chanslor/ESP32_HYDRO_STATIC/price-list.txt

HiLetgo  INA219 I2C Bi-Directional DC Current Power Supply Sensor Breakout Module - $8.19

915 MHz ESP32 LoRa 32 V3 OLED Display Board + LoRa32 V3 Case Cover + LoRa Antenna 915MHz for Heltec Meshtastic LoraWan IOT  - $25

HiLetgo  LM393 3.3V-5V Soil Moisture Detect Sensor Soil Moisture Sensor Soil Hygrometer - $2

Snapware Total Solution Food Storage Container, Plastic, Rectangle, 8.5 Cups - $7 

SEFEPODER 12 Volt 7ah Rechargeable Sealed Lead Acid Battery - $15

Liquid Level Sensor, TL-136 12-32VDC 4-20mA Signal Output Anti-blocking Water Level Sensor Detector, Liquid Level Transmitter(0-1m) - $44.54
