chanslor/ESP32_HYDRO_STATIC/Heltec-amazon.png

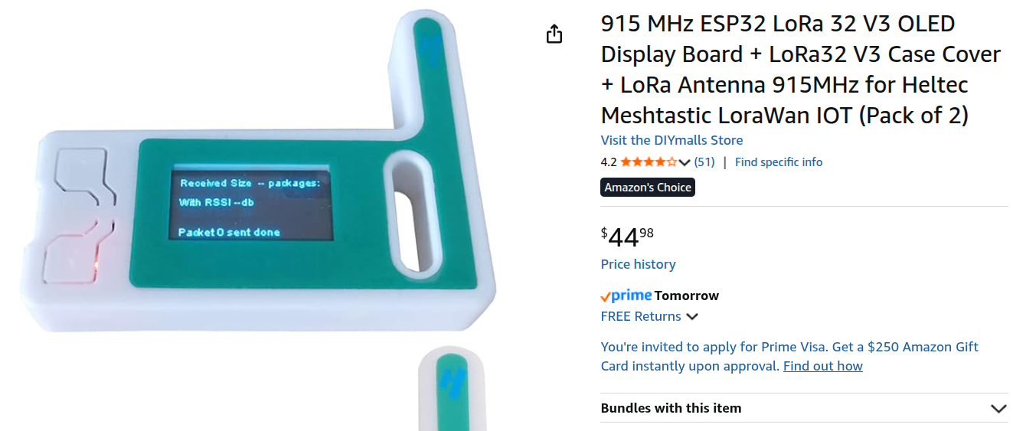
Heltec-amazon.png
