chanslor/ESP32_HYDRO_STATIC/orginal-design.jpg

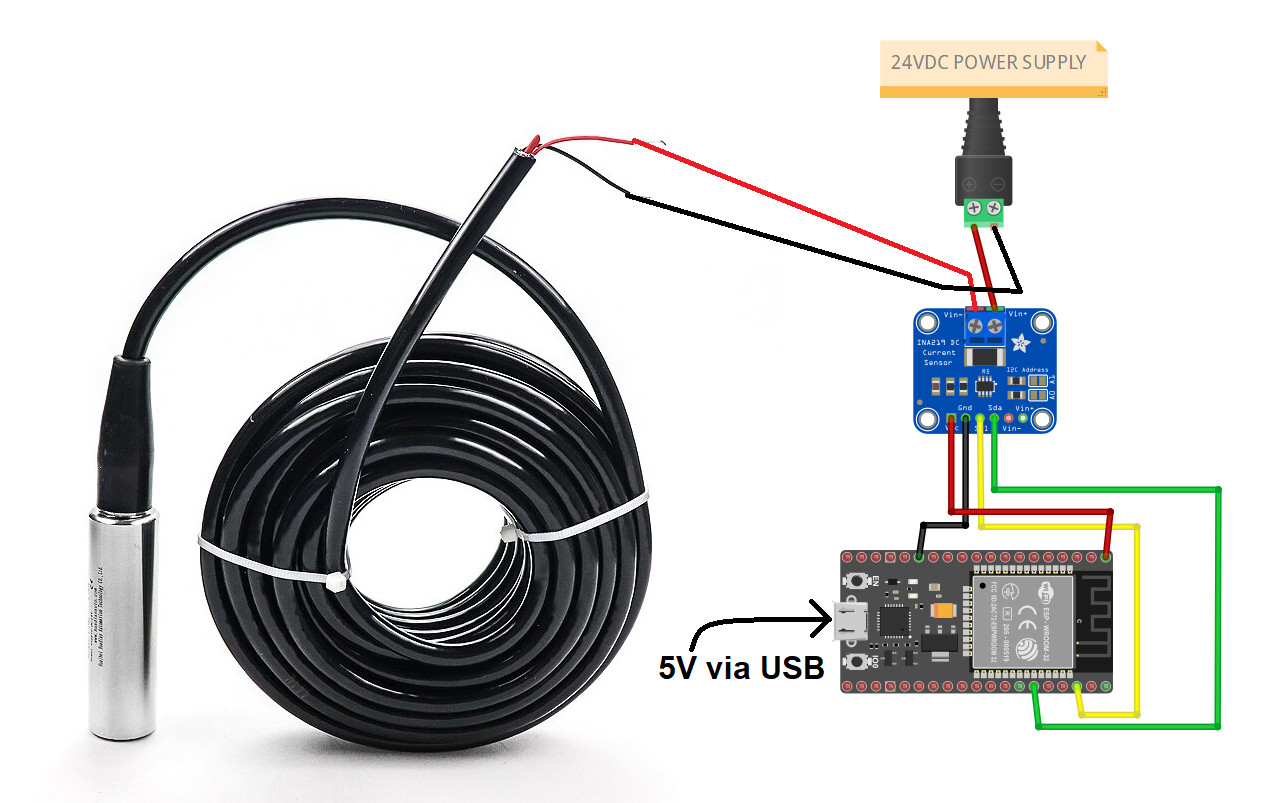
orginal-design.jpg
