chanslor/ESP32_HYDRO_STATIC/(commit log)

2025-11-24 Working project with Sensor and display
    [partitions.csv]
2025-12-03 Moisture sensor addition
2025-12-03 New sensor picture.
2025-12-07 Ridge Relay added
    [partitions.csv]
2025-12-07 Home unit for LoRa communications
    [partitions.csv]
2025-12-07 Added backup relay from ridge top
    [partitions.csv]
2026-06-12 add river_unit
    [partitions.csv]
2026-06-12 Add price list with TL-136 sensor pricing
